stephenangelico/BioBox/(list of files, drawings)

Other design files:
Diagrams/circuit.fz
