stephenangelico/BioBox/browser.py

# WebSocket server for potential integration with BioBox
# Uses asyncio. If the rest of the project does too, create listen() as a task;
# otherwise, spin off run() as a thread.
import time
import asyncio
import json
import ssl
from pprint import pprint
from collections import defaultdict
import websockets # ImportError? pip install websockets

sockets = defaultdict(list)
callbacks = { }
sites = {
	"music.youtube.com": "YT Music",
	"www.youtube.com": "YouTube",
	"www.twitch.tv": "Twitch",
	"clips.twitch.tv": "Twitch Clips",
	"www.disneyplus.com": "Disney+", # IF THIS CHANGES, also update Browser.write_external, Browser.muted, and tab_volume_changed.
	"": "Browser: File",
}

class Browser(Channel):
	group_name = "Browser"
	max = 100 # Most video players don't do anything with volume above 100%
	
	def __init__(self, sockid, tabid, tabname):
		super().__init__(name=tabname)
		self.sockid = sockid
		self.tabid = tabid

	def write_external(self, value):
		if not self.mute.get_active() or self.channel_name != "Disney+":
			spawn(set_volume(self.sockid, self.tabid, (value)))
		# On Disney+, mute also sets volume to zero. Setting volume unmutes as well.
	
	def muted(self, widget):
		mute_state = super().muted(widget) # Handles label change and IIDPIO
		spawn(set_muted(self.sockid, self.tabid, mute_state))
		if not mute_state and self.channel_name == "Disney+":
			self.write_external(self.oldvalue)
			# As we suspend sending volume while muted on Disney+,
			# we now need to send the current volume in case it has changed.
			# We don't do this on all tabs because there can be a delay
			# between unmuting and the volume updating.

class WSConn():
	def __init__(self, sockid, sock):
		self.sockid = sockid
		self.sock = sock
		self.tabs = {}

async def volume(sock, path):
	if path != "/ws": return # Can we send back a 404 or something?
	sockid = None
	try:
		async for msg in sock:
			try: msg = json.loads(msg)
			except json.decoder.JSONDecodeError: continue # Ignore malformed messages
			if not isinstance(msg, dict): continue # Everything should be a JSON object
			if "cmd" not in msg: continue # Every message has to have a command
			if msg["cmd"] == "init":
				if msg.get("type") != "volume": continue # This is the only socket type currently supported
				if "sockID" not in msg: continue
				sockid = str(msg["sockID"])
				if sockid not in sockets:
					conn = WSConn(sockid, sock)
					sockets[sockid] = conn
				else:
					sockets[sockid].sock = sock
			elif msg["cmd"] == "newtab":
				host = str(msg["host"])
				tabid = str(msg["tabid"])
				if tabid not in sockets[sockid].tabs: # sockid is set during init
					cb = callbacks.get("newtab")
					if cb: cb(sockid, tabid, host)
			elif msg["cmd"] == "closedtab":
				tabid = str(msg["tabid"])
				if tabid in sockets[sockid].tabs: # sockid is set during init
					cb = callbacks.get("closedtab")
					if cb: cb(sockid, tabid)
			elif msg["cmd"] == "setvolume":
				tabid = str(msg["tabid"])
				cb = callbacks.get("volumechanged")
				if cb: cb(sockid, tabid, msg.get("volume", 0), bool(msg.get("muted")))
			elif msg["cmd"] == "beat":
				pass
			else:
				print(msg)
	except websockets.ConnectionClosedError:
		pass
	# If this sock isn't in the dict, most likely another socket kicked us,
	# which is uninteresting.
	if sockid:
		for tab in sockets[sockid].tabs.values():
			tab.remove() # Remove from GUI
		sockets.pop(sockid)

async def send_message(sockid, msg):
	await sockets[sockid].sock.send(json.dumps(msg))

async def keepalive():
	while True:
		await asyncio.sleep(20)
		for conn in sockets.values():
			try:
				await conn.sock.send(json.dumps({"cmd": "heartbeat"}))
			except websockets.exceptions.ConnectionClosedOK:
				print("Possible old sock:", conn.sockid)
			except websockets.exceptions.ConnectionClosedError:
				# Should be handled by volume() after its try/except
				print("Possible lost connection:", conn.sockid)

async def set_volume(sockid, tabid, vol):
	# What happens if the buffer fills up and we start another send?
	# Ideally: prevent subsequent sends until the first one finishes, but remember the latest
	# volume selection made. If that's not the same as the first volume, send another after.
	await send_message(sockid, {"cmd": "setvolume", "tabid": tabid, "volume": vol})

async def set_muted(sockid, tabid, muted):
	await send_message(sockid, {"cmd": "setmuted", "tabid": tabid, "muted": bool(muted)})

async def listen(start_time, *, host="", port=8888):
	callbacks.update(newtab=new_tab, closedtab=closed_tab, volumechanged=tab_volume_changed)
	ssl_context = ssl.SSLContext(ssl.PROTOCOL_TLS_SERVER)
	try:
		ssl_context.load_cert_chain("fullchain.pem", "privkey.pem")
	except FileNotFoundError:
		# No cert found. Not an error, just don't support encryption.
		ssl_context = None
	try:
		async with websockets.serve(volume, host, port, ssl=ssl_context) as ws_server:
			ka = spawn(keepalive())
			print("[" + str(time.monotonic() - start_time) + "] Websocket listening.")
			await asyncio.Future()
	except OSError as e:
		if e.errno!=(98): # 98: Address already in use
			raise # Task should automatically complete on return if it was errno 98
	finally:
		#print("Websocket shutting down.") # I don't hate you!
		ka.cancel()
		try:
			await ka
		except asyncio.CancelledError:
			pass

# Channel management
def new_tab(sockid, tabid, host):
	if host in sites:
		tabname = sites[host]
	else:
		tabname = host
	print("Creating channel for new tab:", tabid, tabname)
	tab = Browser(sockid, tabid, tabname)
	sockets[sockid].tabs[tabid] = tab

def closed_tab(sockid, tabid):
	print("Destroying channel for closed tab:", tabid)
	sockets[sockid].tabs[tabid].remove() # Remove channel in GUI
	sockets[sockid].tabs.pop(tabid, None) # Remove from socket's list of tabs

def tab_volume_changed(sockid, tabid, volume, mute_state):
	print("On", tabid, ": Volume:", volume, "Muted:", bool(mute_state))
	channel = sockets[sockid].tabs[tabid]
	if channel.channel_name != "Disney+" or not mute_state:
		channel.refract_value(float(volume), "backend")
	# Disney+ has a mute function which mutes the video *and* sets video volume to 0.
	# This is weird because everything else so far leaves the video volume alone on mute.
	# To prevent the slider from moving on mute, ignore the volume value if muted.
	channel.mute.set_active(int(mute_state))

# Non-asyncio entry-point
def run(**kw): asyncio.run(listen(**kw))
if __name__ == "__main__":
	try:
		run()
	except KeyboardInterrupt:
		pass
