stephenangelico/BioBox/(commit log)

2021-02-13 README: Add mute button to mock-up
2021-02-17 BioBox: Add range and snap marker to slider
    [BioBox.py]
2021-02-17 BioBox: Add POC socket connection to TellMeVLC
2021-03-12 README: Specify slider and ADC connections
2021-03-19 Revert "README: Fix order of pins on slider"
    Turns out I second-guessed myself in that commit and we do need +3.3V on slider
    pin R1 so it connects to L1 to give the full 10KΩ range.
2021-03-20 Revert "Revert "README: Fix order of pins on slider""
    Lesson learned: ALWAYS test on the actual device before making assumptions.
    We ACTUALLY need CH0 on slider pin R1, not because I know why, but because the
    ADC reports 99% regardless of the slider's actual position otherwise.
2021-03-20 BioBox: Make the Mute button do something
2021-03-20 BioBox: Print unrecognized signals from TellMeVLC
2021-04-02 BioBox: Print selected channel on radio button toggled
2021-04-02 BioBox: Print Autofocus state on mute button toggled
2021-04-02 Analog: Fix read before assignment
    [Analog.py]
2021-04-03 Analog: Rework read_value to yield instead of printing to console
    [Analog.py]
2021-04-03 Analog: Fix broken referencing from previous rework
    [Analog.py]
2021-04-03 BioBox: Label debug print calls
2021-04-03 BioBox: Rework channel adjustment to 'refract' changes to multiple outputs
    This allows a movement on the slider to be carried through to a networked
    source, or vice versa, by changing the GTK Adjustment.
    [BioBox.py]
2021-04-03 BioBox: Fix VLC.write_external reading GTK widget now that refract_value does
    [BioBox.py]
2021-04-10 BioBox: provide dummy read_value() for testing
    Analog.py will not work on a generic Linux PC as board.py does not support that,
    so rather than finding a way to get a low-level dummy analog input, a high-level
    dummy was easier to create.
    [BioBox.py]
2021-04-10 BioBox: Fix WebcamFocus.write_external in line with VLC.write_external
    [BioBox.py]
2021-04-10 BioBox: Complete TODO for setting mute button label on toggle
2021-04-10 BioBox: Fix auto-focus protection detection
    [BioBox.py]
2021-04-10 BioBox: Complete TODO for checking camera state on startup
2021-04-17 BioBox: Replace time.time() with time.monotonic() in case of leap seconds
    [BioBox.py]
2021-04-24 Biobox: Send abstract AF and focus distance commands over SSH to camera.py
2021-05-01 BioBox: Refactor VLC socket connection to be in __init__
2021-05-01 BioBox: Fix reference to socket connection after refactor
    [BioBox.py]
2021-05-08 BioBox: Block socket ops if connection is not open (partially complete TODO)
2021-05-15 camera: Tidy EOFError on close
2021-05-15 BioBox: Use Gtk.Frame instead of EventBox in ongoing attempt to pass signals
2021-05-15 BioBox: Grab button and widget focus events to select channel
2021-05-22 README: Add motor controller pin connections
2021-05-29 Add interactive testing script for motor control
2021-05-29 README: Update module list and fix pinout guide to current hardware state
2021-05-29 README: Add plans for motor library
2021-06-05 Motor: Re-work as internal library
2021-06-05 Motor: Fix stop and brake commands
    [Motor.py]
2021-06-06 Prevent SSH from requesting a password
    [BioBox.py]
2021-06-11 First cut at the actual Chrome extension side of things
2021-06-12 Analog: Add motor movement function
2021-06-12 Analog: Add boilerplate motor calls
2021-06-12 Analog: Tweak motor thresholds and add IIDPIO for testing
2021-06-19 BioBox: Integrate motor movement into channels
2021-06-19 BioBox: Fix reference to write_analog() in Channel class
    [BioBox.py]
2021-06-19 BioBox: Add motor cleanup to read_analog()
2021-06-19 BioBox: Add motor debounce
2021-06-19 BioBox: Add motor debounce to read_analog() as well
2021-06-19 BioBox: Fix slider_last_wrote not declared as global in read_analog()
    [BioBox.py]
2021-06-19 BioBox: Add delay to motor movement on startup
2021-06-19 BioBox: Set initial motor goal
2021-06-19 BioBox: Fix motor init reference in MainUI init
    [BioBox.py]
2021-06-19 BioBox: ... And fix motor init to require self
    [BioBox.py]
2021-06-19 BioBox: Move motor cleanup to main thread
2021-06-26 Analog: Track bounds values in test_span()
2021-06-26 Analog: Fix test iterations to be 100, not 99
    [Analog.py]
2021-07-17 BioBox: Move update_position to superclass (So far only VLC replaces it)
    [BioBox.py]
2021-07-17 BioBox: Track tabIDs to channels to change volume
2021-07-17 BioBox: Fix use of *args in shim
    [BioBox.py]
2021-07-24 Analog: Fix reference before assignment
    [Analog.py]
2021-07-24 BioBox: Reset debounce time to 0.01s now that it actually means something
    [BioBox.py]
2021-07-24 Analog: Set debounce time to ~1 tick to avoid fighting
    [Analog.py]
2021-07-24 BioBox: Only write_analog if selected - fixes new module moving slider
    [BioBox.py]
2021-07-31 Pass camera device path from BioBox.py to camera.py
2021-08-07 BioBox: Add task for connecting to OBS - prints audio sources on current scene
2021-08-21 README: Rename potentiometer range wire (L1 <-> R3) to "bragging wire"
    Credit to Rosuav for making the joke on Twitch.
2021-08-21 README: Add notes and data collection for resistance drift
2021-08-21 README: Add explanation of "bragging wire"
2021-08-21 README: Add codeblocks to resistance testing sets
2021-08-21 BioBox: Use camera device name for AF debug message
2021-08-28 BioBox: Add and remove modules from OBS according to current scene
2021-09-04 BioBox: Remove print calls on SourceVolumeChanged and SourceMuteStateChanged
2021-09-11 BioBox: Fix mute request in OBS modules
    [BioBox.py]
2021-09-11 BioBox: Ask asyncio to update OBS now*, not when it gets around to a new task
    * asyncio does not work with "now" in the true sense, but it's close enough.
    [BioBox.py]
2021-09-18 Analog: Adjust lower ADC bound
2021-09-18 Analog: Change test function to print raw values
2021-09-25 Motor: After braking for a moment, call stop() to pull pins low
2021-09-25 Analog: Brake the motor on reaching the goal instead of just stopping
2021-09-25 Motor: Brake for 0.1sec as 0.01sec appeared insufficient
2021-09-25 Analog: Don't yield after reaching goal until motor has braked
2021-09-25 Analog: Move motor debug message to before doing stuff
2021-09-25 Analog: Add debug function to move slider and get raw ADC values
2021-09-25 Analog: Now that motor is braked on reaching goal, don't slow down as much prior
2021-10-02 Analog: Make raw value printout less spammy
2021-10-09 README: Reseat bragging wire and get fresh data
    For the first time in months, 0% < 32768 on the ADC. Wiring weaknesses may be
    the entire cause of drift, but the solution may be easier said than done.
2021-10-16 Analog: Track and shift interpolation points at 10% intervals
2021-10-16 Analog: Fix syntax error on return in bounds_test
    [Analog.py]
2021-10-16 Analog: Divide ADC value by 64 in test mode
2021-10-16 Analog: Fix direction of scaling within 10% blocks
    [Analog.py]
2021-10-23 Analog: Fix time_boundaries to use boundary values from interp_values
    [Analog.py]
2021-10-23 Analog: Add direction-inverted copy of time_boundaries()
    [Analog.py]
2021-10-30 BioBox: Add CSS framework to window
2021-11-06 BioBox: Insert modules into their group rather than at the end
2021-11-19 Make WebSocket into a task rather than a thread
2021-11-20 BioBox: Fix references to removed functions/methods
    [BioBox.py]
2021-12-04 BioBox: Convert VLC connection from threaded socket to asyncio
2021-12-04 BioBox: Remove socket dependency (now done with asyncio)
2021-12-11 Give back device name from camera.py cam_check
2021-12-11 Specify webcam device with each command rather than on connection
2022-01-01 config: Add dictionary of webcam names to devices
2022-01-08 Complete asyncio refactor of webcams
    This also changes the format of info from camera.py (device: attr: value)
2022-01-08 Add error handling on webcam init
    TODO: use similar error handling on commands
    [BioBox.py, camera.py]
2022-01-14 camera: Add checks to focus_auto and focus_absolute for wrong device or value
    [camera.py]
2022-01-15 Wait for response from camera.py before initializing webcam modules
2022-01-21 Dispense with sending quit signal to camera.py
2022-01-29 Untested POC of a simple error handling wrapper
    [BioBox.py]
2022-01-29 BioBox: Isolate webcam module removal issue to termination of camera.py
    [BioBox.py]
2022-01-29 camera: Add newline at end of file
2022-01-29 BioBox: Remove noisy print on removing modules
2022-01-29 BioBox: Remove poker for webcam issue (if needed, switch to debug-webcam branch)
    [BioBox.py]
2022-02-26 BioBox: Add (currently non-functional) menu to toggle module groups
2022-03-12 BioBox: Fix fallback read_value complaining about argument it didn't want
    [BioBox.py]
2022-03-12 BioBox: Remove old read_external and replace with read_asyncio
    Nothing was using read_external, and only VLC uses read_asyncio.
    [BioBox.py]
2022-03-12 BioBox: Revert d035e1 - unable to launch in fallback mode
    It will be fine to be a little noisy until the TODO is completed.
    [BioBox.py]
2022-03-12 BioBox: Add TODO with plan to properly fix debounce and slider fighting
    [BioBox.py]
2022-03-19 BioBox: Rework refract_value to stop slider fighting hopefully once and for all
    [BioBox.py]
2022-03-19 BioBox: Fix spelling error in previous commit
    [BioBox.py]
2022-03-19 BioBox: Replace objects with parameters to identify source of volume change
    [BioBox.py]
2022-03-19 Analog: Stop motor if it seems to be stuck
    [Analog.py]
2022-04-02 BioBox: Fix spin in read_analog when using fallback read_value
    [BioBox.py]
2022-04-02 BioBox: Fix references to running tasks, enabling VLC to start and stop
    [BioBox.py]
2022-04-03 BioBox: FIX slider fighting, ONCE AND FOR ALL! (hopefully)
    [BioBox.py]
2022-04-09 Replace subprocessing with direct ioctls for V4L2
    [camera.py]
2022-04-16 BioBox: Remove redundant socket close call
2022-04-16 BioBox: Disambiguate print calls on module selection and removal
2022-04-30 Replace asyncio_glib with gbulb and MAGICALLY fix event loop stalling
    [BioBox.py]
2022-04-30 Analog: Don't engage safety brakes because of slider jiggle
2022-05-07 Motor: Add sleep() - wrapper to standby() which sets speed 0 and engages brake
2022-05-07 Analog: Remove use of BioBox.main.stop and use Motor.sleep in all functions
2022-05-14 Motor: change sleep() to use stop() instead of brake()
    brake() uses the short-brake function of the TB6612FNG, which causes a brief
    short-circuit *across* the motor, causing it to act like a dynamo and it rapidly
    loses kinetic energy. This short-circuit is disconnected from power, so it won't
    cause damage other than a little heat while braking, which at this scale is
    negligible.
    It is possible that braking vs stopping will have a difference in precision, but
    that is not of concern when simply putting the motor on standby.
    [Motor.py]
2022-05-28 BioBox: Remove need for stop event in slider, removing noisy crash on PC
    [BioBox.py]
2022-05-28 Handle webcam device not found errors gracefully (remove module only)
    [BioBox.py, camera.py]
2022-07-23 Catch more errors to prevent shutdown hangs
    [BioBox.py]
2022-08-13 volsock: Remove Twitch Dashboard pages - even if they have video elements, BioBox control may not be necessary (ie stream preview on main dashboard). Regardless, volsock.js will currently add a tab e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
2022-08-27 Add debug info to camera-BioBox protocol
2022-08-27 BioBox: Remove TODO for SSH cleanup - turns out telling the other end you're leaving is a good idea so it doesn't wait up for you
    [BioBox.py]
2022-08-27 BioBox: Remove old GTK Label (now built into module frame)
2022-10-15 BioBox: Remove TODO for Twitch pages and add name for Twitch clips
    [BioBox.py]
2022-10-15 BioBox: Add missing comma from previous commit
    [BioBox.py]
2022-10-15 BioBox: Remove TODO - suspected no longer required
    [BioBox.py]
2022-11-12 Analog: Set pin numbering mode to BCM (same as in Motor.py)
2022-11-12 BioBox: Add another error on import to handle if not running on RPi
    [BioBox.py]
2022-11-12 Analog: Replace interpolation system with simple arithmetic scaling
    The new slider is within measurement error of linear, and even has physical dead
    zones, so no need for the whole complex system which was built to work around
    a slider unfit for this job.
    [Analog.py]
2022-11-18 BioBox: Set per-module min and max to avoid querying GTK slider
    [BioBox.py]
2022-11-19 Analog: Fix case in motor call in bounds_test
    [Analog.py]
2022-11-19 Analog: Remove bounds_test - no longer useful with new slider
    [Analog.py]
2022-11-19 Analog: Invert values in print_value so it's not confusing
    [Analog.py]
2022-11-19 Analog: Fix direction of motor in test_slider and add comment and TODO
    [Analog.py]
2022-11-25 Analog: Complete TODO on safety brakes deque size
2022-11-25 Analog: Collapse print calls to reduce spam and increase readability
2022-11-26 Analog: Change order of values to print
2022-12-02 Analog: Add pos to print line
2022-12-03 BioBox: Complete TODO - We DO need slider_last_wrote currently
2022-12-03 Analog: Remove safety brakes as they were only getting the slider stuck at 1023
    [Analog.py]
2022-12-03 BioBox: Add debug print call when a goal is dropped
2022-12-10 BioBox: Fix styling on site-to-name mapping
    [BioBox.py]
2022-12-17 Analog: Switch from braking to stopping on completing goal
    Does not appear to make a huge difference in accuracy of goal but
    further testing required. The main point was to avoid
    time.sleep(0.1) in Motor.brake before it sets to Motor.stop anyway.
    [Analog.py]
2022-12-17 BioBox: Check by tolerance instead of equality in refract_value
    [BioBox.py]
2022-12-17 Analog: Reduce tolerance to gain slider precision
    [Analog.py]
2022-12-17 Toy with a script to move the motor around smoothly
2022-12-18 ease: Enable motor standby (so the motor actually runs)
2022-12-18 ease: Add overshoot calculation
    [ease.py]
2022-12-24 ease: Replace static dist->speed mapping with dynamically floored calculation
    [ease.py]
2023-01-14 BioBox: Fix composition of batch request
    [BioBox.py]
2023-02-04 BioBox: Remove debug print call in Channel
2023-02-04 obs: Fix reference to OBS connection object
    [obs.py]
2023-02-04 obs: Fix detection of groups and scenes
    [obs.py]
2023-02-04 BioBox: Switch OBS module to that in obs.py
2023-02-10 obs: Fix group name
    [obs.py]
2023-02-11 Modify camera protocol to allow specifying mode (eg focus, exposure)
2023-02-12 Retain spawned tasks in a list to avoid premature garbage collection
    [BioBox.py]
2023-02-12 Improve error handling, including noticing errors sooner
    [BioBox.py]
2023-02-14 BioBox: Use 3.8-compatible print_exception args
2023-02-14 Wait for stdout to close rather than the process to terminate.
    This should hopefully avoid the spew of unwaited proc.wait calls.
    [BioBox.py]
2023-02-14 BioBox: Avoid cleanup() when SSH connection is already gone
    [BioBox.py]
2023-02-18 Break out webcam to new file and add support for camera exposure
2023-02-18 BioBox: Add a couple of TODOs
2023-02-25 BioBox: Add toolbar with all modules (same as menu contents currently)
2023-02-25 BioBox: Fix toggling OBS in menu/toolbar
    [BioBox.py]
2023-03-25 BioBox: Implement auto-expand window by size-allocate signal (WIP)
    Currently does not actually auto-expand but there are oddities with sizes
2023-04-08 Oops, remove debug print
2023-04-22 BioBox: Complete TODO - first channel is now selected on startup
    Also places focus on mute button of first channel to allow easy channel
    switching with left and right arrow keys as well as quick mute/auto toggle.
2023-05-06 Break out VLC module into separate file
    Side note: this was surprisingly painless. Would be a pity if something broke
    when it gets to the Pi...
    [BioBox.py, vlc.py]
2023-05-13 Add Frizting circuit design and image
    [circuit.fz]
2023-05-27 Update Fritzing files with schematic and move to folder to keep tidy
    [circuit.fz]
2023-05-27 circuit: Fix +5V wire to breadboard
    [circuit.fz]
2023-05-27 README: Fix wiring table and add images
2023-06-03 Diagrams: Add markers for connectors and add SVGs of breadboard and schematic
    [circuit.fz]
2023-06-03 README: Begin write-up of wiring
2023-06-17 Diagrams: Fix schematic wire colour for +5V at motor controller
    [circuit.fz]
2023-06-17 README: Add complete wiring instructions (and a TODO)
2023-06-24 browser: Fix reference to class for creating channel
    [browser.py]
2023-07-08 Motor: Put initialization stuff in a function where it belongs
2023-07-08 Analog: Add TODOs to track how to progress this conversion
2023-07-22 Motor: Make pwm a global now that it's defined in a function
2023-07-22 Analog: spawn read_value as a task, and make it do something now that it doesn't need to yield anywhere
    [Analog.py]
2023-08-05 Motor: Stop PWM in cleanup
2023-09-16 Cleanup PWM and MCP properly when cancelling slider
2023-09-30 BioBox: Fix touching empty area in click_anywhere (still inactive on elements)
    [BioBox.py]
2023-10-20 browser: Remove old reference to WebSocket
    This has been broken since the rename/rework of Websocket.py to browser.py, and
    I only just noticed this week when I wanted it to work.
    [browser.py]
2023-10-28 BioBox: Update TODO in click_anywhere and filter more event types
2023-11-04 BioBox: Add print call to adjustment_changed if it changes selected_channel
2023-11-04 BioBox: Fix calling focus_select
    [BioBox.py]
2023-11-10 BioBox: Disable a couple of spammy debug print calls
2023-11-11 BioBox: Add timer to debug init_select_channel
2023-11-11 Add debug timer to all modules
2023-11-24 Motor: Fix missing pwm if cleanup() is run before init()
    [Motor.py]
2023-11-24 Motor: Protect sleep() in cleanup with pwm check
2023-11-25 Analog: Add motor test using context manager
2023-11-25 Analog: Fix motor test - multiple derps and deque adjustment to get motor going
    [Analog.py]
2023-12-01 Analog: Add a couple of TODOs
2023-12-01 README: Complete TODO for motor test
2024-02-10 background: Fix context of socket object
2024-02-17 volsock: Switch listener to switch statement
2024-03-09 volsock: Break after each case in extListen - caused mute on any volume change
2024-03-09 background: Remove extID print as the reason it was added is fully understood
2024-03-09 volsock: Remove extID print (same reason as for background.js)
2024-03-30 background: Add heartbeat function (currently unused) and describe other options
2024-04-20 browser: Fix overwriting 'group' with WS connection group
    [browser.py]
2024-04-20 browser: Avoid potential confusion of 'newtab'
    [browser.py]
2024-04-20 browser: Manage each list of tabs in its own socket connection object
2024-04-20 browser: Fix heartbeat to work with new WSConn object
    [browser.py]
2024-04-20 browser: Reinstate socket removing self from list, inc tab cleanup
2024-04-27 browser: Fix reference to open tabs in socket connections
    [browser.py]
2024-04-27 browser: Fix getting wrong tabid (was getting newest tab) in setvolume
    [browser.py]
2024-05-18 volsock: Hack YTM to click mute button as needed
2024-06-01 webcam: Remove TODO for error which was never observed
    [webcam.py]
2024-06-01 browser: Handle connection errors in heartbeat
    [browser.py]
2024-06-01 obs: Cleanly handle ConnectionClosedError (which occurs if you yank the cable)
2024-06-01 browser: Remove TODO for problem I can no longer reproduce
    [browser.py]
2024-06-08 obs: Handle more network-related issues
    [obs.py]
2024-06-08 vlc: Copy network error handling from OBS
    [vlc.py]
2024-06-15 BioBox: Fix naming of tasks and task names
    [BioBox.py]
2024-06-15 vlc: Fix explanation of error 111 (Connection Refused)
    [vlc.py]
2024-07-06 Clean up a lot of unnecessary printout incl deprecation warnings
2024-07-06 browser: Remove last debug print, negating need for TODO
2024-08-10 BioBox: Fix automatic restarting of tasks if their toggle is off
    [BioBox.py]
2024-08-10 spotify: Print just current volume from playback state
2024-08-31 spotify: Rework vol_update to be a one-and-done with single backoff on 429
    [spotify.py]
2024-09-14 spotify: Force IPv4 connections until IPv6 routing is fixed on this LAN
    [spotify.py]
2024-09-14 spotify: Fix channel init
    [spotify.py]
2024-09-14 spotify: Fix/cleanup/add print calls throughout module
    [spotify.py]
2024-10-05 Fix muting on D+ by ignoring/blocking volume changes while muted
    [browser.py]
2024-10-05 browser: Fix reference to channel name (derp)
    [browser.py]
2024-11-29 Motor: Add a TODO
2024-11-30 Motor: Update TODO with more info
